masato-ka/qdd-torque-jig/out/assembly.step

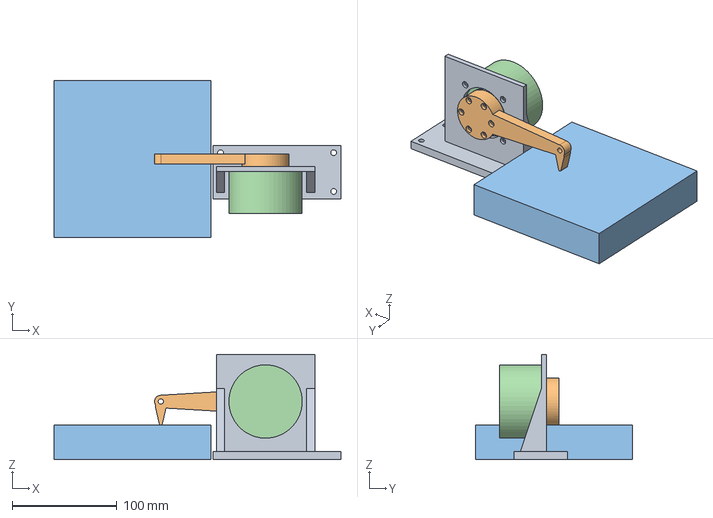
[picture p3: CAD file, 2026-10-04]
out/assembly.step
274.0 x 150.0 x 100.5 mm
