masato-ka/qdd-torque-jig/out/arm.stl

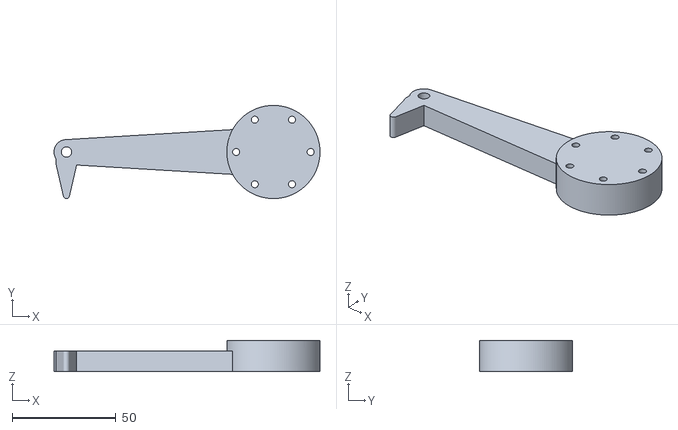
[picture p4: CAD file, 2026-10-04]
out/arm.stl
128.5 x 45.0 x 15.0
