masato-ka/qdd-torque-jig/out/base.stl

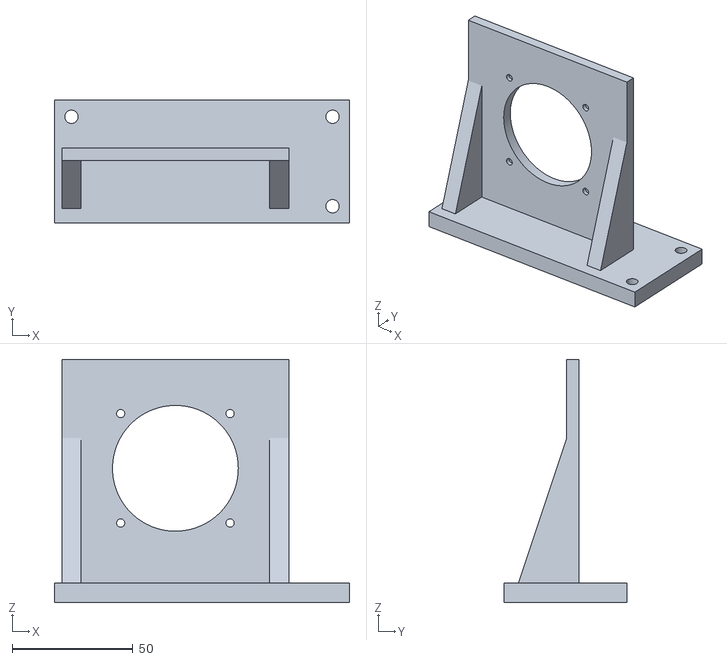
[picture p5: CAD file, 2026-10-04]
out/base.stl
122.0 x 51.0 x 100.5
